semify-eda/tristan/core/custom/obi_wb_bridge/doc/multicycle obi wb bridge.png

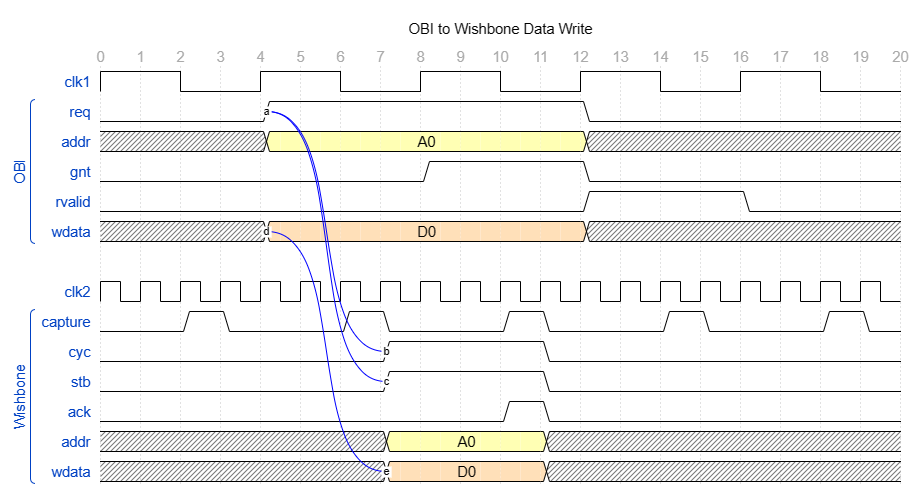
core/custom/obi_wb_bridge/doc/multicycle obi wb bridge.png
