semify-eda/tristan/core/custom/obi_wb_bridge/doc/OBI to WB rData with Reset.png

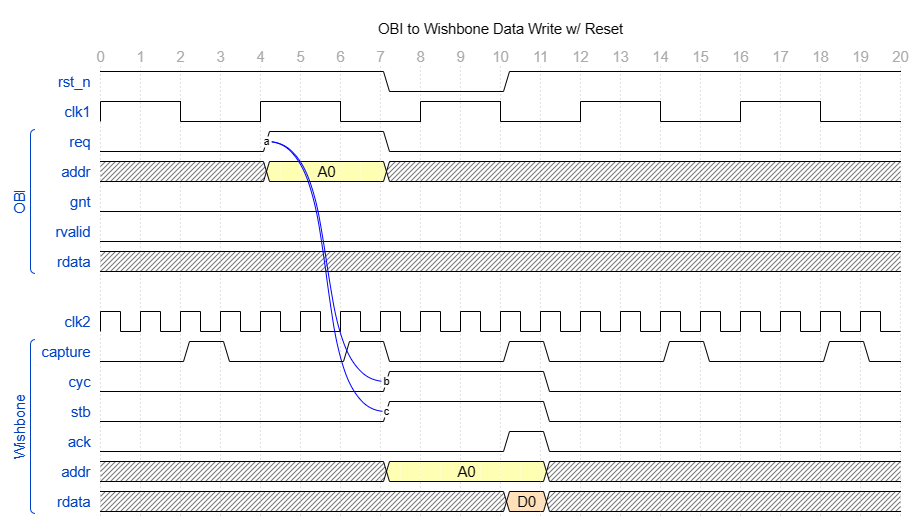
core/custom/obi_wb_bridge/doc/OBI to WB rData with Reset.png
