semify-eda/tristan/core/custom/wb_ram_interface/doc/wishbone ram read.png

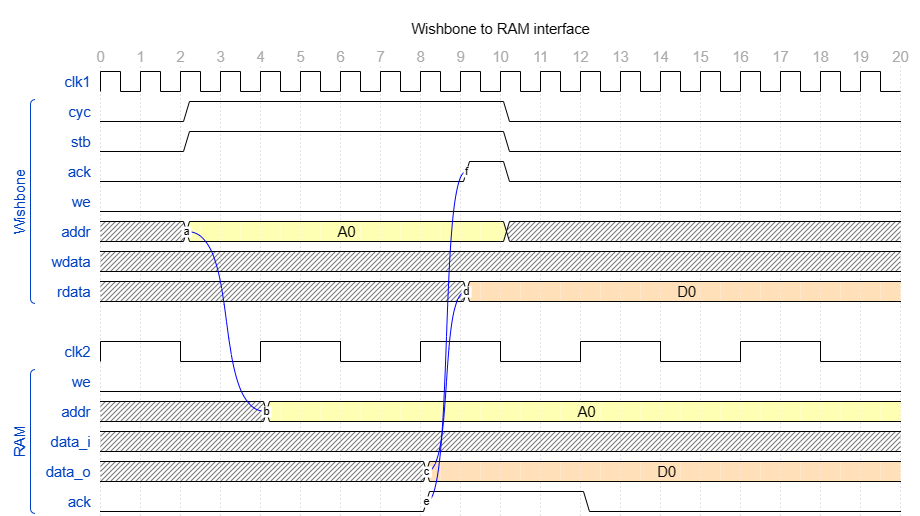
core/custom/wb_ram_interface/doc/wishbone ram read.png
