semify-eda/tristan/core/custom/wb_ram_interface/doc/wishbone ram write.png

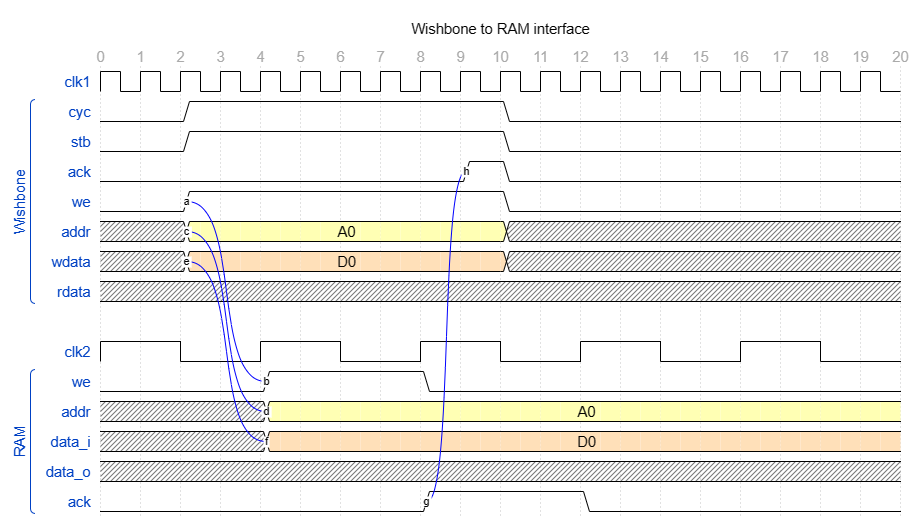
core/custom/wb_ram_interface/doc/wishbone ram write.png
