semify-eda/tristan/(threads)

Thread 8 (2023-10-20):

Refactoring of C code

kstrohmayer, 2023-10-20:

kstrohmayer, 2023-10-22:
Pefectly fine for me.

adam-hrvth, 2023-11-03:
@kstrohmayer @mole99
After our discussion with Klaus, we've decided to investigate the root cause of the encoding errors before making significant algorithm changes. I suspect there may be an issue with the 'prepare_data' function, the data buffer, or where 'rle_compress' fetches the signal for encoding, or perhaps a combination of these two. Even when I feed various random data bits into the 'prepare_data' buffer, the output remains the same, as shown in the attached picture from the first five test runs. It's puzzling that the counted consecutive bits are often fewer than the bits in 'bits_rle_block,' preventing compression. While I'm not entirely certain about the correctness, you can find the output in the attached picture.

I have a separate repository for RLE algorithm testing in Visual Studio. If you want to run a test while I'm away, just check out the 'rle_encoding' branch and run the 'rle.vcxproj' file. This should open Visual Studio for debugging. If you encounter issues, it might be due to the project not being in Console mode, and you can refer to this article for help: https://www.codeproject.com/Questions/5289599/How-do-I-resolve-my-LNK2019-error-in-my-program

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

adam-hrvth, 2023-11-13:
One of the reasons the data in the buffer wasn't changing correctly is that Mario was rewriting the content of the buffer with `strcpy((char*)data, "Hello World!");` before passing it to the `rle_compress` function. I have uploaded some of the results to [Google Drive](https://drive.google.com/drive/u/0/folders/1G4SrC4tp43L9c4dusqkUEcXOBKE-bw-f). The results from 0-9 bypass the part of rewriting the buffer. Results from 10-19 use Mario's original code.

Even though I am generating random data bits for each iteration, I only observe some minor changes in the data buffer. However, the data being sent to the `rle_compress` function remains consistently the same.

kstrohmayer, 2023-11-13:
> Even though I am generating random data bits for each iteration, I only observe some minor changes in the data buffer. However, the data being sent to the `rle_compress` function remains consistently the same.

Might be the case because he only changes the "data word" of the SPI transfer he emulates.

kstrohmayer, 2023-11-13:
> One of the reasons the data in the buffer wasn't changing correctly is that Mario was rewriting the content of the buffer with `strcpy((char*)data, "Hello World!");` before passing it to the `rle_compress` function. I have uploaded some of the results to [Google Drive](https://drive.google.com/drive/u/0/folders/1G4SrC4tp43L9c4dusqkUEcXOBKE-bw-f). The results from 0-9 bypass the part of rewriting the buffer. Results from 10-19 use Mario's original code.

Does it work now?

adam-hrvth, 2023-11-13:
Unfortunately, not yet. The prepare_data function uses a data pointer as a buffer to store the clock, sync, data, and clear signals. However, from my tests, it seems like the data buffer is not handled correctly and doesn't return the correct data to the compression algorithm..

```
---- RLE test run: 0 ----

---- Prepare Data ----
Data bits: 0x3b37
DAC data: 0x103b370
Empty Data Buffer: 00000053798FF6E8

--- Print Data from buffer ---
Data: 00000053798FF6E8

```

kstrohmayer, 2023-11-13:
Is the required memory for the data buffer allocated?

adam-hrvth, 2023-11-14:
> Is the required memory for the data buffer allocated?

Not in the original code. I did add a memory allocation before calling the prepare data function `data[DATA_BYTE_SIZE] = malloc(sizeof(uint8_t));`  but I haven't seen any difference in the results.

adam-hrvth, 2023-11-17:
The `cntb_test` skips most of the RLE algorithm by not using the `prepare_data` function. It generates random values and start positions, successfully returning consecutive bits, functioning well in both software and hardware. However, when I ran the `rle_test` with the same input data as the `cntb_test`, I obtained different results. It seems the `rle_compression` function is not handling the input data correctly, leaving most bits uncompressed. I recommend a code review and may need additional support. Test [cntb](https://drive.google.com/file/d/15smhcmzC3CzMK10v1jayL4zpuEN7Pl1y/view?usp=drive_link) and [rle ](https://drive.google.com/file/d/1729vvCFYv5ggFdUs_ohyY-rS8TIZeqKs/view?usp=drive_link)results are available on Google Drive.

kstrohmayer, 2023-11-18:
Hi Adam,
Let's do a call on Monday morning. I'm travelling with Gottfried to Photeon by car. So I don't know exactly when I can do the call.
I'll ping you.

adam-hrvth, 2023-11-20:
> Hi Adam, Let's do a call on Monday morning. I'm travelling with Gottfried to Photeon by car. So I don't know exactly when I can do the call. I'll ping you.

That's fine, but I think it would be better to do this either in person or when I can share my screen so we could go through my test results.

adam-hrvth, 2024-01-02:
I have updated the RLE algorithm to achieve a better compression ratio. Currently, the algorithm no longer relies on the not_compressed flag for storing or decompressing data accurately. This modification has led to a reduced number of bits stored in the bitstream/memory, resulting in an improved compression ratio. With the given sample data, the following reductions have been achieved:

- CLK: 64-bits reduced to only 12-bits, with an 81.25% reduction in size.
- SYNC: 64-bits reduced to 48-bits, with a 25% reduction in size.
- DATA: 64-bits reduced to 42-bits, with a 34.38% reduction in size.
- CLR: 64-bits reduced to 28-bits, with a 56.25% reduction in size.

It's important to note that these results are subjective, as they depend on the consecutive bits found in each signal. The CLK signal demonstrates the best result due to its all-one's nature.

adam-hrvth, 2024-01-09:
The current implementation of the RLE algorithm, running on the ULX3S FPGA, gives the following results.
Measured with Saleae Logic 8 logic analyser.

| | With Custom Instruction | Without Custom Instruction |
|      :---:      |     :---:      |     :---:      |
| RLE Run time (ms)   | 66.05704| 74.02218  |
| Improvement in ms    |   7.96514   |
| Improvement in percentage    | 10.76%  |
