semify-eda/tristan/core/include/soc_pkg.sv

`ifndef SOC_PKG
`define SOC_PKG
package soc_pkg;

    typedef enum logic{
        INTERNAL = 1'b0, // inside SOC (i.e. D-MEM, I-MEM,...)
        EXTERNAL = 1'b1 // external to SOC (i.e. over the OBI-WB bridge to SmartWave)
    } e_chip_sel;

    typedef enum logic[2:0] {
        DRAM = 3'h0,
        IRAM = 3'h1,
        UART = 3'h2
    } e_block_sel;

endpackage
`endif
