semify-eda/tristan/(commit log)

2023-05-08 Work on SoC with SPI Flash
2023-05-08 Integrate SPI Flash, adjust firmware
2023-05-15 Arbitration working, UART output
2023-05-30 SPI Flash with delay now works
2023-10-12 Fixes for flash controller integration
    [cv32e40x_soc.sv]
2023-12-05 Fix small issue in cntb_soft
    [instr.h]
2024-01-08 Fixed format error with print function
    [rle.c]
2024-03-08 Move RAM back into soc and switch to DP
2024-03-11 Swap SPI flash with BRAM
    [cv32e40x_soc.sv, ulx3s_top.sv]
2024-03-18 added bridge to SoC, issues with direct memory access in compilation still exist
    [cv32e40x_soc.sv, main.c]
2024-03-19 Fixed memory addressability bug causing firmware to malfunction
    [cv32e40x_soc.sv]
2024-03-25 fixed bug which switched iram and dram address masks
    [cv32e40x_soc.sv]
2024-03-26 renamed dualport ram module name to avoid collisions with the wfg dualport ram
    [core_sram.sv, cv32e40x_soc.sv]
2024-03-27 Added simple timer module
2024-03-27 removed uart
2024-03-28 fixed double acknowledge bug and updated address mapping
    [wb_ram_interface.sv, wb_ram_test.py]
2024-04-03 Updated timer
2024-04-09 blinking led
2024-04-10 fixed i2ct addressability bug and changed lighting effect
    [main.c]
2024-04-10 moved top level tb to correct spot
    [top_tb.py, top_tb.sv]
2024-04-15 update reset synchronization for soc
    [cv32e40x_soc.sv]
2024-04-16 rmoved UART from SoC
2024-04-16 added logic for smooth resets for soc and global cases
    [obi_wb_bridge.sv]
2024-04-23 sensor emulation working through new C hardware interface
2024-05-23 update bridge with fixed reset signals
    [obi_wb_bridge.sv, obi_wb_bridge_tb.sv, obi_wb_bridge_test.py]
2024-05-23 update resets on wishbone to soc ram and update tb
    [wb_ram_interface.sv, wb_ram_tb.sv, wb_ram_test.py]
2024-05-27 fix bridge resp signal
    [obi_wb_bridge.sv, obi_wb_bridge_test.py]
2024-08-07 fix floating extension interface signals bug
    [coproc.sv]
2024-08-20 fix xif timing bugs
    [coproc.sv]
2024-08-29 verify and fix shifter
    [coproc.sv, rshifter32.sv, shifter_tb.sv, shifter_test.py]
2024-08-29 store working except for edge case where count = 32
2025-08-27 quick patch for decoding bug .
    [coproc.sv]
2026-03-17 comment memory debug print
2026-03-17 fixing some smaller bugs
    [top_tb.sv]
2026-03-17 adding file to ignore VCA6 warnings in verilator print
2026-03-17 fix wishbone transcation, made mistake in previous commit
    [top_tb.sv]
2026-03-17 fixing some verilator warning
    [rshifter32.sv, top_tb.sv]
2026-03-26 fixing data_arbiter, code cleanup (comments added to the new arbiter and SOC)
    [cv32e40x_soc.sv, obi_data_bus_arbiter.sv]
2026-04-17 update all files to load 4 firmware in parallel. the totla firmware size doubled (requiring one more address bit), while each single firmware can only 2k words long (instead of 4k). there is no way t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
2026-05-21 updating default firmware with the new separation between SPI and I2S
2026-06-08 adding printing of the wishbone transactions
2026-06-08 Big Readme and comment update to document current state
